AveAng02/Auto-Toilet-Flush-System-ATFS-/README.md

# Auto Toilet Flush System or ATFS

**PROJECT OBJECTIVE**
>     To build a prototype of an automatic toilet flushing system for the Indian Ecosystem. 
> Thus providing the safety of contactless toilet amidst the COVID19
> pandemic. The project employs an Arduino UNO to sense the presence of an individual, further 
> counts the seconds of presence to confirm that the toilet is in use. An electromagnetic flush
> mount is used to pull up when required and the tank is full.

**MATERIALS REQUIRED**
1. Arduino UNO
2. 9V Battery & Battery Cap
3. 5V Relay X 2
4. 220V AC to 12V DC Converter
5. Arduino Housing Box
6. PCB Prototyping Board
7. AC Connection Wire
8. Polyolefin Heat Shrink Tube
9. PIR Motion Sensor
10. Sensor Housing Box
11. Copper Coil
12. Ferrite Magnetic Rings

**DELIVERABLES/ MILESTONES**
1. Core Code
2. Relay board
3. Flush Mount
4. Tuned PIR Module
5. Arduino Housing Box
6. Sensor Housing Box

**TECHNICAL REQUIREMENTS**
1. 220V AC
2. Standard Indian Water Closet
3. standard Arduino UNO 

**LIMITS AND EXCLUTIONS**
