AveAng02/Auto-Toilet-Flush-System-ATFS-/tank flush cross section diagram.jpg

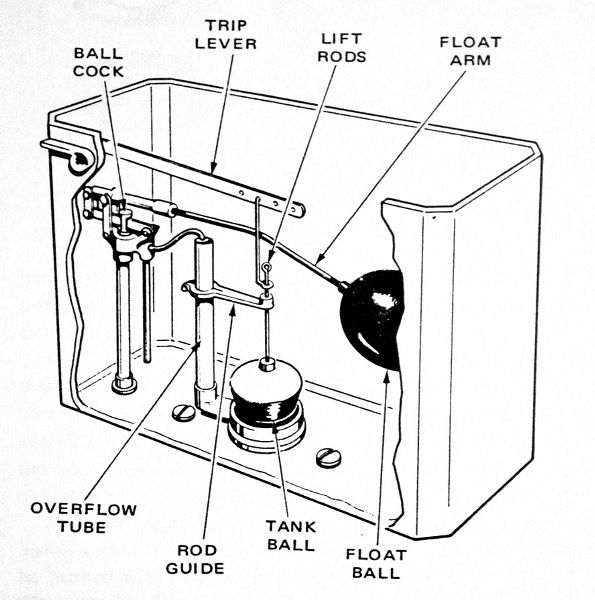
tank flush cross section diagram.jpg
